vincentballendat/brakechopperRoot/Entwicklungsdokument/Brake_chopper_InOut.pptx

Temp (PCB, mounting base, casing)
Total Current
Battery Voltage

CAN TX/RX

System

1 x Powerstage vCtrl
5 x Powerstage Enable
3 x LEDs
1 x Fan Enable

## Slide 2

State Machine Diagram

Startup

Calibration
(if Vbat connected) (Powerstage, ADC)

Ready (VCtrl = 0, SHDN = 0)

CAN: take load

CAN: no load

Overtemp (VCtrl = 0, SHDN = 0)

CAN: take load

Burn Energy (VCtrl != 0, SHDN != 0)

CAN: no load

Powerstages set and measured

Burn Energy
SOA Throttling (VCtrl != 0, SHDN != 0)

## Slide 3

Ready State Housekeeping

Power-Handler
setSOACurrent();
setVCtrl();

Timer
ADC Filtering, powerHandler,
calculateExcessCurrent,
setCurrent

CAN Interrupt
New excess current

Calculate excess current
= -motorLinkCurrent
-generatorPower/Voltage
-Battery chargeCurrent 2S

Calculate dissipationCurrent
Adjusts excess current current if higher than:
SOAPower
MaxTempdependentPower
Ptot Mosfet

dissipationCurrent

setCurrent

setSOACurrent();

100Hz

setVCtrl();

setVCtrl()
Adjusts the DAC to output the voltage representing the dissipationCurrent

setCurrent
dissipationCurrent
Activates Powerstages depending on current and calibration

setCurrent();
