vincentballendat/brakechopperRoot/Can Motor controller CAN Messages.PNG

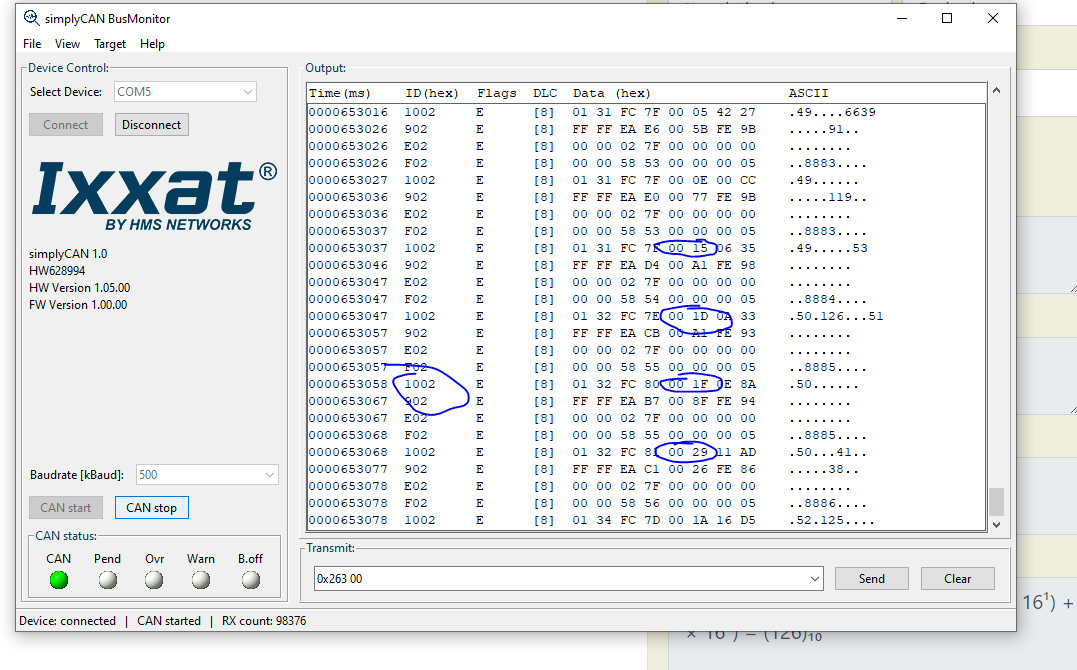
Can Motor controller CAN Messages.PNG
