vincentballendat/brakechopperRoot/Entwicklungsdokument/Example Layout DCDC.PNG

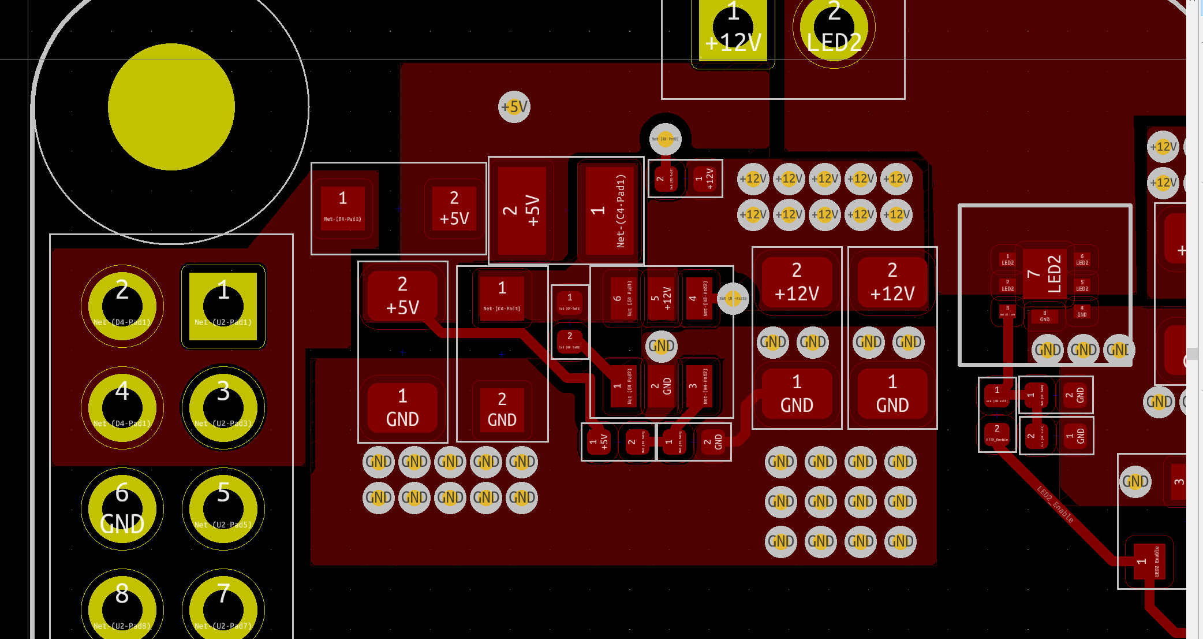
Entwicklungsdokument/Example Layout DCDC.PNG
