vincentballendat/brakechopperRoot/KiCad/Brake_Chopper/Brake_Chopper_BOM.xlsx

Id | Designator | Package | Quantity | Designation | Supplier and ref | Preis/ Stk (ab 10 stk) | Gesamtpreis / PCB
1 | L2,L1 | L_1008_2520Metric | 2 | 4,7uH |  | 1.77 € | 3.54 € | https://www.mouser.de/ProductDetail/NXP-Semiconductors/TJA1050T-CM118?qs=5XOdhvmYM0NFFspw0VP5sA%3D%3D
2 | C9,C8,C2,C3 | C_0805_2012Metric | 4 | 10uF |  |  | 0.00 €
3 | D4,D10,D3,D5,D7,D6,D8,D9 | LED_0603_1608Metric | 8 | LED |  |  | 0.00 €
4 | R49,R55,R53,R46,R6,R44,R57,R56,R40,R14,R52,R54,R59,R51,R5,R10,R58,R13,R42,R1,R50,R8,R25 | R_0402_1005Metric | 23 | 10k |  |  | 0.00 €
5 | R15,R16,R43,R17,R39,R3,R23,R27,R31,R35 | R_0402_1005Metric | 10 | 1k |  |  | 0.00 €
6 | C15,C14,C16,C17,C18 | C_2220_5650Metric | 5 | 10u 100V! |  | 1.31 € | 6.55 € | https://www.mouser.de/ProductDetail/KYOCERA-AVX/22201C106MAT2A?qs=LGawwvMOr29m3pBB9JVCfA%3D%3D
7 | R12,R38 | R_0402_1005Metric | 2 | 4,7k |  |  | 0.00 €
8 | C38,C13,C27,C29,C21,C12,C35,C33,C39,C26,C22,C28,C1,C41,C20,C32,C40,C19,C37,C25,C30,C36,C11,C34,C23,C10 | C_0402_1005Metric | 26 | 100n |  |  | 0.00 €
9 | D12,D11,D13 | LED_D5.0mm | 3 | LED |  |  | 0.00 €
10 | R4,R24,R32,R28,R36 | R_2512_6332Metric | 5 | 30m | D1MPAC2512QR030FA-T4 | 0.14 € | 0.70 € | https://www.digikey.com.br/en/products/detail/thin-film-technology-corp/D1MPAC2512QR030FA-T4/16735398
11 | R45 | R_0402_1005Metric | 1 | 120 |  | 0.01 € | 0.01 € | https://www.mouser.de/ProductDetail/KOA-Speer/RK73H1ETTP1200F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
12 | D2,D1 | D_SOD-123F | 2 | DS14W |  |  | 0.00 €
13 | U7,U6 | PE24_SMD_IBT | 2 | SMT NAT M4 (Redcube) |  | 0.26 € | 0.52 €
14 | U11,U10,U9,U8,U1 | SOT-23-6 | 5 | TLV9101SIDBVR |  | 0.74 € | 3.70 €
15 | TH1 | R_0402_1005Metric | 1 | Thermistor_NTC | NCU15XH103E6SRC | 0.09 € | 0.09 € | https://www.mouser.de/ProductDetail/Murata-Electronics/NCU15XH103E6SRC?qs=qSfuJ%252Bfl%2Fd6uneJyel0xyQ%3D%3D
16 | U2 | LQFP-48_7x7mm_P0.5mm | 1 | STM32F072C8Tx |  | 4.52 € | 4.52 €
18 | FID3,FID2,FID1,FID4 | Fiducial_0.5mm_Mask1mm | 4 | Fiducial |  |  | 0.00 €
19 | J3 | PinHeader_1x05_P2.54mm_Vertical | 1 | Conn_01x05_Male |  |  | 0.00 €
20 | R60,R11,R9,R7,R48,R18,R33,R37 | R_0402_1005Metric | 8 | 100k |  |  | 0.00 €
21 | R2,R30,R29,R34,R22,R26 | R_0402_1005Metric | 6 | 100R |  | 0.02 € | 0.11 € | https://www.mouser.de/ProductDetail/Vishay-Dale/CRCW0402100RFKED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
22 | FB2,FB3,FB1 | D_0603_1608Metric | 3 | FerriteBead |  | 0.17 € | 0.50 € | https://www.mouser.de/ProductDetail/Wurth-Elektronik/74279265?qs=5twSNpOB8IBYQvSbutOy0w%3D%3D
23 | R41 | R_0402_1005Metric | 1 | 65k |  | 0.01 € | 0.01 € | https://www.mouser.de/ProductDetail/YAGEO/AC0402FR-0764K9L
24 | C4,C5 | C_0805_2012Metric | 2 | 68pF |  | 0.03 € | 0.06 € | https://www.mouser.de/ProductDetail/Walsin/0805N680J201CT
25 | C31 | C_0805_2012Metric | 1 | 1u |  |  | 0.00 €
26 | U13 | SOT-23 | 1 | PESD2CAN |  | 0.42 € | 0.42 € | https://www.mouser.de/ProductDetail/Nexperia/PESD2CAN215?qs=LOCUfHb8d9sqg7TaLUP2JQ%3D%3D
27 | R21 | R_2512_6332Metric | 1 | 0R01 | CRF2512-JZ-R010ELF | 0.35 € | 0.35 € | https://www.mouser.de/ProductDetail/Bourns/CRF2512-JZ-R010ELF?qs=Xowbq3obBahhwSE1OziLPA%3D%3D
28 | C6,C7 | C_0805_2012Metric | 2 | 220n |  | 0.02 € | 0.04 € | https://www.mouser.de/ProductDetail/Samsung-Electro-Mechanics/CL21B224KBFNNNG
30 | Q2 | PowerPAK_SO-8_Single | 1 | SIRA18ADP-T1-GE3 |  | 0.37 € | 0.37 € | https://www.mouser.de/ProductDetail/Vishay-Semiconductors/SIRA18ADP-T1-GE3?qs=ojKcPFmCWSVrk7Ja81e2IA%3D%3D
31 | U3 | SOIC-8_3.9x4.9mm_P1.27mm | 1 | TJA1051T | TJA1050T/CM,118 | 1.77 € | 1.77 € | https://www.mouser.de/ProductDetail/NXP-Semiconductors/TJA1050T-CM118?qs=5XOdhvmYM0NFFspw0VP5sA%3D%3D
32 | U4,U5 | SOT-23-6 | 2 | ME3116 |  | 0.21 € | 0.42 €
33 | J1 | JST_XH_B04B-XH-A_04x2.50mm_Straight | 1 | Conn_01x04_Male |  |  | 0.00 €
34 | J2,J5,J4 | JST_XH_B02B-XH-A_02x2.50mm_Straight | 3 | Conn_01x02_Male |  |  | 0.00 €
35 | R20,R19 | R_0402_1005Metric | 2 | 470k |  | 0.01 € | 0.02 € | https://www.mouser.de/ProductDetail/YAGEO/RC0402FR-13470KL?qs=sGAEpiMZZMvdGkrng054t5h1zTYPh4vhbyn0hIjpgP8%3D
36 | U12 | SOT-23-6 | 1 | INA181 | INA181A1QDBVRQ1 | 0.58 € | 0.58 € | https://www.mouser.de/ProductDetail/Texas-Instruments/INA181A1QDBVRQ1?qs=EBDBlbfErPx7yYU5sEtaJQ%3D%3D
38 | Q1,Q3,Q6,Q5,Q4 | TO-220-3_Horizontal_TabUp | 5 | PSMN057-200P |  | 1.22 € | 6.10 €
 |  |  | 1 | Gehäuse | L02A | 15.16 € | 15.16 €
 |  |  | 1 | Kabel |  | 2.00 € | 2.00 €
 |  |  |  |  |  | Gesamt: | 47.55 €
