vincentballendat/brakechopperRoot/Bauteile/Bestellliste_Digikey.xlsx

Index | Menge | Teilenummer | Hersteller-Teilenummer | Beschreibung | Kundenreferenz | Verfügbar | Lieferrückstände | Stückpreis | Gesamtpreis USD
1 | 238 | 2156-PSMN057-200P,127-1727-ND | PSMN057-200P,127 | NEXPERIA PSMN057-200P - 39A, 200 |  | 238 | 0 | 126000 | 29988
2 | 2 | 497-15096-ND | NUCLEO-F072RB | NUCLEO-64 STM32F072RB EVAL BRD |  | 2 | 0 | 1099000 | 2198
3 | 25 | 296-TLV9101SIDBVRCT-ND | TLV9101SIDBVR | IC OPAMP GP 1 CIRCUIT SOT23-6 |  | 25 | 0 | 77240 | 1931
4 | 10 | 497-17358-ND | STM32F072C8T6 | IC MCU 32BIT 64KB FLASH 48LQFP |  | 10 | 0 | 468600 | 4686
5 | 100 | 4463-D1MPAC2512QR030FA-T4CT-ND | D1MPAC2512QR030FA-T4 | RES 2512 50PPM 0.03 OHM 1.0% 3.0 |  | 100 | 0 | 14960 | 1496
6 | 1 | 1738-1374-ND | FIT0010 | JUMPER WIRE M TO M VARIOUS |  | 1 | 0 | 470000 | 470
7 | 1 | 1568-1511-ND | PRT-12794 | JUMPER WIRE M/F 6" 20PCS |  | 1 | 0 | 210000 | 210
8 | 1 | BKEXP-355-ND | EXP-355 | BREADBRD TERM STRIP 4.12X2.31" |  | 1 | 0 | 755000 | 755
9 | 1 | PA0085-ND | PA0085 | SOT23-6/SC59-6 TO DIP-6 SMT ADAP |  | 1 | 0 | 269000 | 269
