vincentballendat/brakechopperRoot/Bauteile/Nachbestellung Bauteile.xlsx

Bauteil | Bezeichnung | Preis/ Stk (ab 10 stk) | Anzahl | Gesamtpreis | Link
CAN Transceiver NUR MIT REFERENCE VOLTAGE PIN VERFÜGBAR | TJA1050T/CM,118 | 1.77 € | 10 | 17.70 € | https://www.mouser.de/ProductDetail/NXP-Semiconductors/TJA1050T-CM118?qs=5XOdhvmYM0NFFspw0VP5sA%3D%3D
MOSFET für Lüfter | SIRA18ADP-T1-GE3 | 0.37 € | 10 | 3.73 € | https://www.mouser.de/ProductDetail/Vishay-Semiconductors/SIRA18ADP-T1-GE3?qs=ojKcPFmCWSVrk7Ja81e2IA%3D%3D
Shunt für Gesamtstrom | CRF2512-JZ-R010ELF | 0.35 € | 10 | 3.55 € | https://www.mouser.de/ProductDetail/Bourns/CRF2512-JZ-R010ELF?qs=Xowbq3obBahhwSE1OziLPA%3D%3D
PESD2CAN | PESD2CAN,215 | 0.42 € | 10 | 4.16 € | https://www.mouser.de/ProductDetail/Nexperia/PESD2CAN215?qs=LOCUfHb8d9sqg7TaLUP2JQ%3D%3D
INA181 | INA181A1QDBVRQ1 | 0.58 € | 10 | 5.81 € | https://www.mouser.de/ProductDetail/Texas-Instruments/INA181A1QDBVRQ1?qs=EBDBlbfErPx7yYU5sEtaJQ%3D%3D
100R Resistor_SMD:R_0402_1005Metric Widerstand | CRCW0402100RFKED | 0.02 € | 200 | 3.60 € | https://www.mouser.de/ProductDetail/Vishay-Dale/CRCW0402100RFKED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
Ferrite Perle | 74279265 | 0.17 € | 30 | 4.98 € | https://www.mouser.de/ProductDetail/Wurth-Elektronik/74279265?qs=5twSNpOB8IBYQvSbutOy0w%3D%3D
65k Resistor_SMD:R_0402_1005Metric widerstand für Spannungsteiler INA181 Ref voltage | AC0402FR-0764K9L | 0.01 € | 200 | 2.00 € | https://www.mouser.de/ProductDetail/YAGEO/AC0402FR-0764K9L
220nF= 0,22uF 0805_2012Metric Kondensator DC DC Converter | CL21B224KBFNNNG | 0.02 € | 200 | 4.40 € | https://www.mouser.de/ProductDetail/Samsung-Electro-Mechanics/CL21B224KBFNNNG
68pF 0805_2012Metric Kondensator DC DC Converter | 0805N680J201CT | 0.03 € | 100 | 3.20 € | https://www.mouser.de/ProductDetail/Walsin/0805N680J201CT
10uF_2220_5650Metric 100V Kondensator | 22201C106MAT2A | 1.39 € | 25 | 34.75 € | https://www.mouser.de/ProductDetail/KYOCERA-AVX/22201C106MAT2A?qs=LGawwvMOr29m3pBB9JVCfA%3D%3D
ROT LED_THT:LED_D5.0mm | C5SMF-RJF-CT0W0BB1 | 0.13 € | 10 | 1.31 € | https://www.mouser.de/ProductDetail/Cree-LED/C5SMF-RJF-CT0W0BB1?qs=1sbE9T7hb3YqwRmUPU3V0Q%3D%3D
Grün LED_THT:LED_D5.0mm | C5SMF-GJF-CV0Y0791 | 0.18 € | 10 | 1.81 € | https://www.mouser.de/ProductDetail/Cree-LED/C5SMF-GJF-CV0Y0791?qs=1sbE9T7hb3bLY9RhY5fsuw%3D%3D
Blau LED_THT:LED_D5.0mm | C5SMF-BJE-CR0U0451 | 0.18 € | 10 | 1.81 € | https://www.mouser.de/ProductDetail/Cree-LED/C5SMF-BJE-CR0U0451?qs=1sbE9T7hb3bBR3Yepx7pEw%3D%3D
470k Resistor_SMD:R_0402_1005Metric | RC0402FR-13470KL | 0.01 € | 200 | 2.00 € | https://www.mouser.de/ProductDetail/YAGEO/RC0402FR-13470KL?qs=sGAEpiMZZMvdGkrng054t5h1zTYPh4vhbyn0hIjpgP8%3D
120R Resistor_SMD:R_0402_1005Metric für CAN | RK73H1ETTP1200F | 0.01 € | 200 | 2.60 € | https://www.mouser.de/ProductDetail/KOA-Speer/RK73H1ETTP1200F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
Termistor NTC Resistor_SMD:R_0402_1005Metric | NCU15XH103E6SRC | 0.09 € | 30 | 2.76 € | https://www.mouser.de/ProductDetail/Murata-Electronics/NCU15XH103E6SRC?qs=qSfuJ%252Bfl%2Fd6uneJyel0xyQ%3D%3D
 |  |  |  | 100.17 €
