vincentballendat/brakechopperRoot/Bauteile/MOSFET/MOSFET_Vergleich.xlsx

MOSFET | VDS | PD | Rth(j-mb) Typ (K/W) | Kosten | Kosten / 100 Watt
IPB020N10N5LF | 100 | 313 | 0.25 | 3.51 € | 1.12 €
IRFP150N | 100 | 160 | 1.1 | 0.80 € | 0.50 €
IRFB4510PBF | 100 | 140 | 1.05 | 1.68 € | 1.20 €
IRF3710PBF | 100 | 200 | 0.75 | 0.79 € | 0.40 €
PSMN3R7-100BSE | 100 | 405 | 0.3 | 4.47 € | 1.10 €
PSMN015-100P,127 | 100 | 300 | 0.5 | 2.48 € | 0.83 € | 2,31 € ab 10 Stück
PSMN057-200P | 200 | 250 | 0.6 | 1.55 € | 0.62 € | Beste Wahl? | Nur im Ausland bestellbar
IXTK90N25L2 | 250 | 960 | 0.13 | 37.36 € | 3.89 €
IXTP32N20T | 200 | 200 | 0.75 | 2.06 € | 1.03 €
IXTK200N10L2 | 100 | 1040 | 0.12 | 39.14 € | 3.76 €
IXTB30N100L | 1000 | 800 | 0.156 | 65.24 € | 8.15 €
IXFB300N10P | 100 | 1500 | 0.1 | 36.03 € | 2.40 €
IXFK230N20T | 200 | 1670 | 0.09 | 26.68 € | 1.60 € | SOA ohne DC aber vielversprechend
