vincentballendat/brakechopperRoot/Messungen + Tests/Strommessverstärker Stromkurve 1,5A -0,3A Step mit Abstecken.jpg

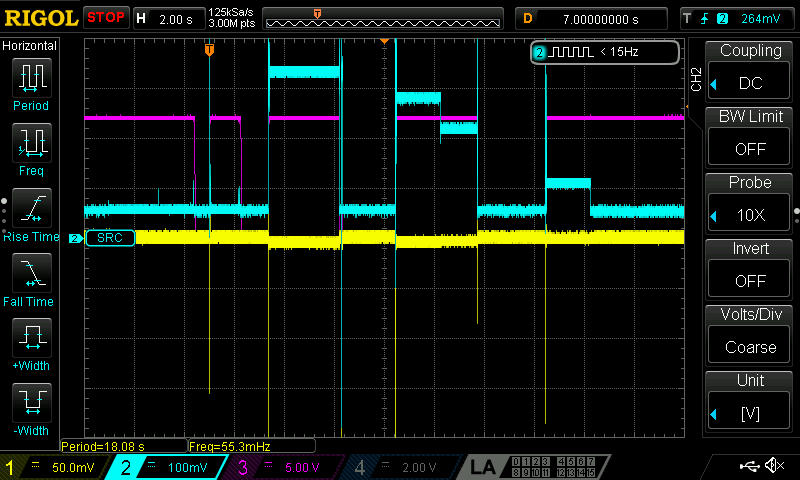
Messungen + Tests/Strommessverstärker Stromkurve 1,5A -0,3A Step mit Abstecken.jpg
