vincentballendat/brakechopperRoot/Messungen + Tests/Strommessverstärker Stromkurve 1,5A -0,3A Step.jpg

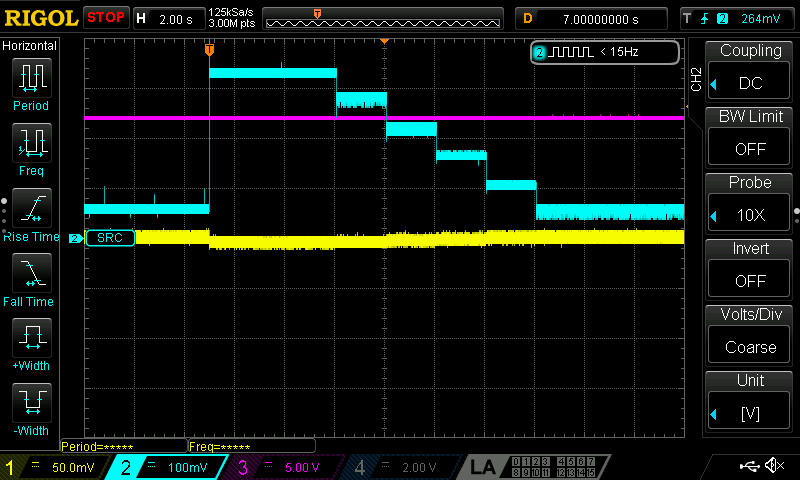
Messungen + Tests/Strommessverstärker Stromkurve 1,5A -0,3A Step.jpg
