vincentballendat/brakechopperRoot/Messungen + Tests/Messungen OpAmp Ausgang.xlsx

Object | Objective | Testing Procedure | Expected result
DC-DC Converter | Correct voltage for 3,3V | Connect +12V and GND to power supply with 0,5A current limit test the 3,3V testing point to GND | 3,3V +-0,2V measured, current stays <0,3A
DC-DC Converter | Correct voltage for 5V | Connect +12V and GND to power supply with 0,5A current limit test the 5V testing point to GND | 5V +-0,2V measured, current stays <0,3A
Results:
