vincentballendat/brakechopperRoot/Messungen + Tests/Messungen Stromfehler - Leg.xlsx

Vbat = 15V
Temp 23°C
Fehler = eingestellter Strom - gemessener Strom
 | Ampere/ Leg | Fehler Leg 1 | Fehler Leg 2 | Fehler Leg 3 | Fehler Leg 4 | Fehler Leg 5 | Gesamtstrom | Summe der Fehler | Prozent
 | 0.1 | 0.006 | -0.007 | 0.009 | 0.009 | 0.006 | 0.500 | 0.024 | 4.76% | -0.007 | -6.58%
 | 0.2 | 0.012 | -0.005 | 0.012 | 0.011 | 0.014 | 1.000 | 0.045 | 4.45% | -0.005 | -2.47%
 | 0.3 | 0.017 | -0.002 | 0.017 | 0.013 | 0.019 | 1.500 | 0.064 | 4.29% | -0.002 | -0.52%
 | 0.4 | 0.022 | 0.000352889299 | 0.020 | 0.014 | 0.026 | 2.000 | 0.082 | 4.09% | 0.000352889299 | 0.09%
 | 0.5 | 0.030 | 0.003 | 0.024 | 0.018 | 0.033 | 2.500 | 0.108 | 4.31% | 0.003 | 0.53%
 | 0.6 | 0.034 | 0.004 | 0.026 | 0.018 | 0.037 | 3.000 | 0.119 | 3.96% | 0.004 | 0.72%
 | 0.7 | 0.039 | 0.006 | 0.030 | 0.020 | 0.044 | 3.500 | 0.140 | 3.99% | 0.006 | 0.92%
 | 0.8 | 0.046 | 0.010 | 0.032 | 0.023 | 0.050 | 4.000 | 0.162 | 4.04% | 0.010 | 1.20%
 | 0.9 | 0.051 | 0.012 | 0.036 | 0.026 | 0.056 | 4.500 | 0.180 | 4.00% | 0.012 | 1.31%
 | 1.0 | 0.057 | 0.014 | 0.040 | 0.026 | 0.061 | 5.000 | 0.199 | 3.98% | 0.014 | 1.41%
 | 1.5 | 0.086 | 0.026 | 0.058 | 0.037 | 0.095 | 7.500 | 0.302 | 4.03% | 0.026 | 1.76%
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
