vincentballendat/brakechopperRoot/Messungen + Tests/Testing_Procedure.xlsx

Object | Objective | Testing Procedure | Expected result
DC-DC Converter | Correct voltage for 3,3V | Connect +12V and GND to power supply with 0,5A current limit test the 3,3V testing point to GND | 3,3V +-0,2V measured, current stays <0,3A
DC-DC Converter | Correct voltage for 5V | Connect +12V and GND to power supply with 0,5A current limit test the 5V testing point to GND | 5V +-0,2V measured, current stays <0,3A
Powerstages | No current upon connecting the battery | Connect BAT+ and BAT- to 12V power supply with 0,5A current limit | Power supply stays in constant voltage mode with a current <0,1A
Powerstages | No current upon connecting the battery | Connect +12V and GND, connect BAT+ and BAT- to 12V power supply with 0,5A current limit | Power supply stays in constant voltage mode with a current <0,1A
Powerstages | For each powerstage the set current gets consumed | Connect +12V and GND to power supply with 0,5A current limit. Connect BAT+ and BAT- to 12V power supply with 2A current limit. Start the testprogram, each Powerstage gets turned on and off individually one after another | Consumed current goes from 0A to 0,5A and back to 0A per powerstage. The LED of each powerstage lights up indicating activation
Powerstages | For each powerstage the set current gets consumed | Connect +12V and GND to power supply with 0,5A current limit. Connect BAT+ and BAT- to 12V power supply with 2A current limit. Start the testprogram, each Powerstage gets turned on and off individually one after another. Connect and disconnect the battery during this procedure | Consumed current goes from 0A to 0,5A +-0,05A and back to 0A per powerstage. The LED of each powerstage lights up indicating activation. The current doesn't show abnormal behaviour.
Voltage sensor | The correct voltage for battery gets measured | Connect +12V and GND to power supply with 0,5A current limit. Connect BAT+ and BAT- to 12V power supply with 2A current limit. Read out the measured voltage with CAN-Command | Measured voltage is 12V +-1V
Current Sensor | The amperage gets measured correctly | Connect +12V and GND to power supply with 0,5A current limit. Connect BAT+ and BAT- to 12V power supply with 2A current limit. Start the testprogram, Read out the measured amperage with CAN-Command | Measured amperage is 1,5A +-0,1A
Temperature Sensor | The temperature gets measured correctly | Let PCB sit for 10 minutes at room temperature, take note of room temperature. Connect +12V and GND to power supply with 0,5A current limit. Read out the measured temperature for temp1, temp2 and temp3 with CAN-Command | Measured temperature for each temperature sensor is room temperature +-5 degree
Fan connector | Fan is controlled correctly | Connect +12V and GND to power supply with 1A current limit. Control the fan with CAN-Command | Fan gets controlled correctly. Turns on and off with CAN-Command
