vincentballendat/brakechopperRoot/Messungen + Tests/01_Fahrversuch/Fahrversuch auswertung.xlsx

Sheet: Tabelle1
Time(ms) | ID(hex) | Flags | DLC | Data (HEX)
166078 | 0 |  | [5] | 0 | 0 | 0 | 0 | 96
166079 | 1AF0FE11 | E | [6] | 0 | 0 | 0 | 0 | 0 | 0
166088 | 1AF0FE11 | E | [6] | 0 | 0 | 0 | 0 | 0 | 0
166098 | 1AF0FE11 | E | [6] | 0 | 0 | 0 | 0 | 0 | 0
166101 | 400 |  | [5] | 0 | 0 | 0 | 0 | 23
166107 | 1AF0FE11 | E | [6] | 0 | 0 | 0 | 0 | 0 | 0
166117 | 1AF0FE11 | E | [6] | 0 | 0 | 0 | 0 | 0 | 0
166121 | 400 |  | [5] | 0 | 0 | 0 | 0 | 30
166127 | 1AF0FE11 | E | [6] | 0 | 0 | 0 | 0 | 0 | 0
166128 | 1AF0FC11 | E | [8] | 0 | 0 | 0 | 64 | 30 | 75
166137 | 1AF0FE11 | E | [6] | 0 | 0 | 0 | 0 | 0 | 0
166138 | 1AF0FB11 | E | [8] | 0 | 0 | 19 | F6 | 0 | 0
166141 | 400 |  | [5] | 0 | 0 | 0 | 0 | 37
166147 | 1AF0FE11 | E | [6] | 0 | 0 | 0 | 0 | 0 | 0
166148 | 1AF0F111 | E | [6] | 11 | 1 | 11 | 1 | 11 | 1
166157 | 1AF0FE11 | E | [6] | 0 | 0 | 0 | 0 | 0 | 0
166161 | 400 |  | [5] | 0 | 0 | 0 | 0 | 3D
166166 | 1AF0FE11 | E | [6] | 0 | 0 | 0 | 0 | 0 | 0
166176 | 1AF0FE11 | E | [6] | 0 | 0 | 0 | 0 | 0 | 0
166181 | 400 |  | [5] | 0 | 0 | 0 | 0 | 41
166186 | 1AF0FE11 | E | [6] | 0 | 0 | 0 | 0 | 0 | 0
166196 | 1AF0FE11 | E | [6] | 0 | 0 | 0 | 0 | 0 | 0
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
