vincentballendat/brakechopperRoot/Messungen + Tests/12V Batterie Voltage Sense Gelb.jpg

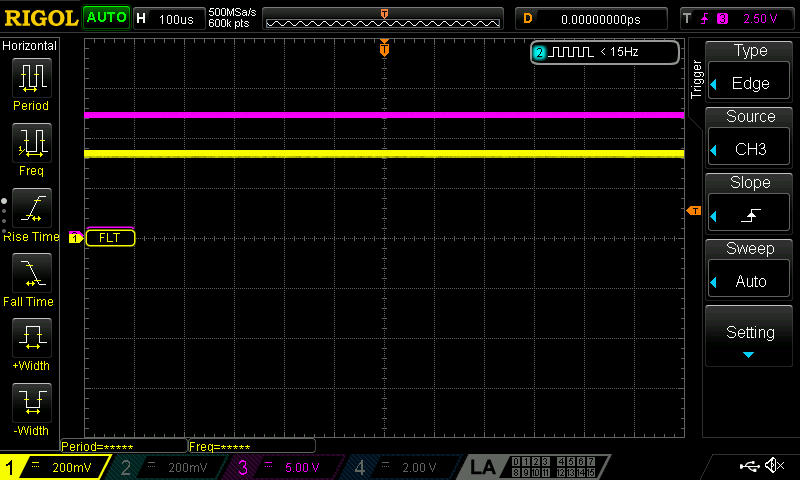
Messungen + Tests/12V Batterie Voltage Sense Gelb.jpg
