vincentballendat/brakechopperRoot/Messungen + Tests/Batterie Anschluss 100ms (Blau Stromverstärker).jpg

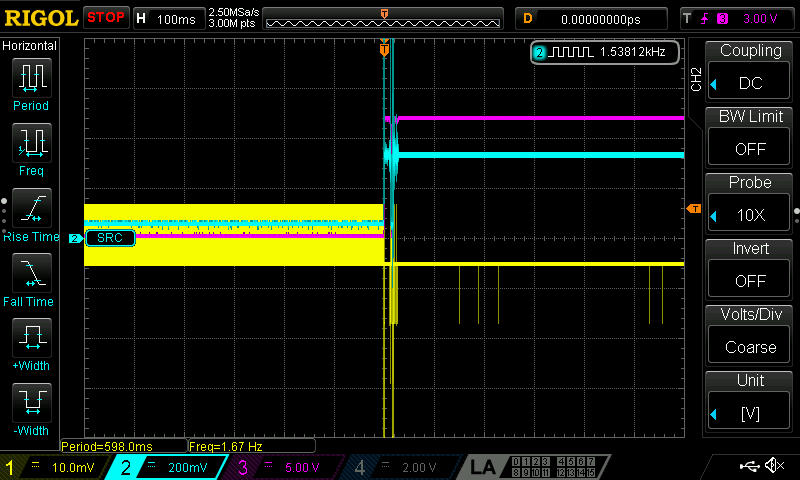
Messungen + Tests/Batterie Anschluss 100ms (Blau Stromverstärker).jpg
