vincentballendat/brakechopperRoot/Messungen + Tests/Batterie Anschluss  VoltageSense.jpg

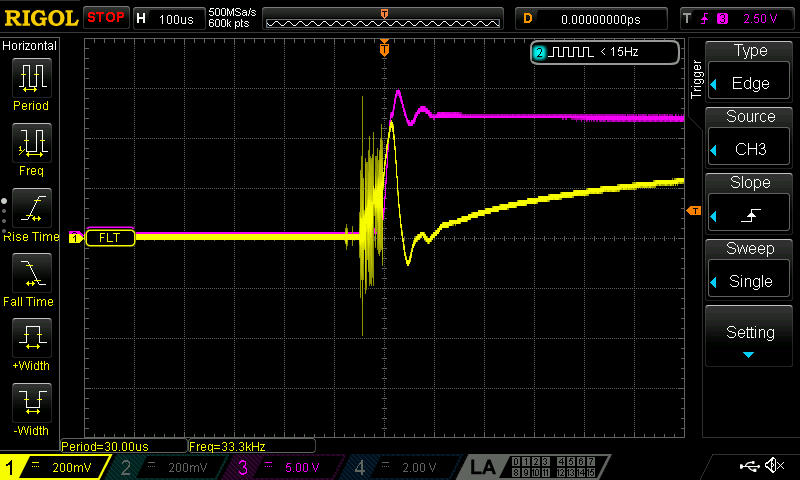
Messungen + Tests/Batterie Anschluss VoltageSense.jpg
