vincentballendat/brakechopperRoot/Messungen + Tests/OPAMP1 Ausgang.jpg

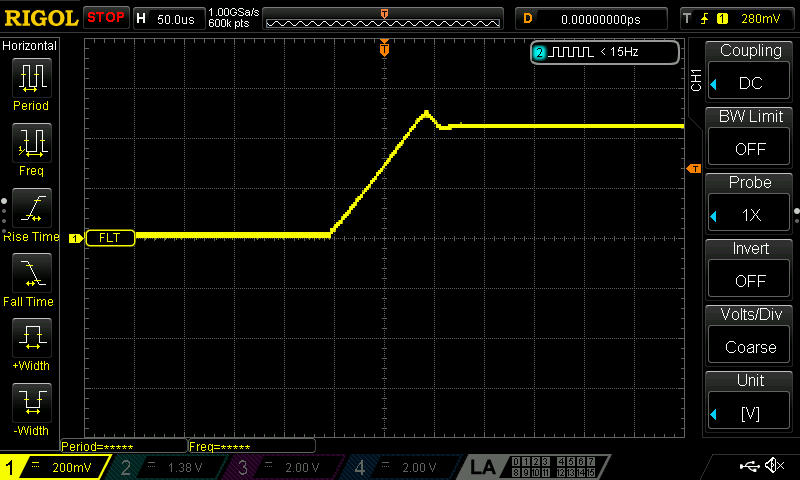
Messungen + Tests/OPAMP1 Ausgang.jpg
