vincentballendat/brakechopperRoot/Messungen + Tests/SHDN1.jpg

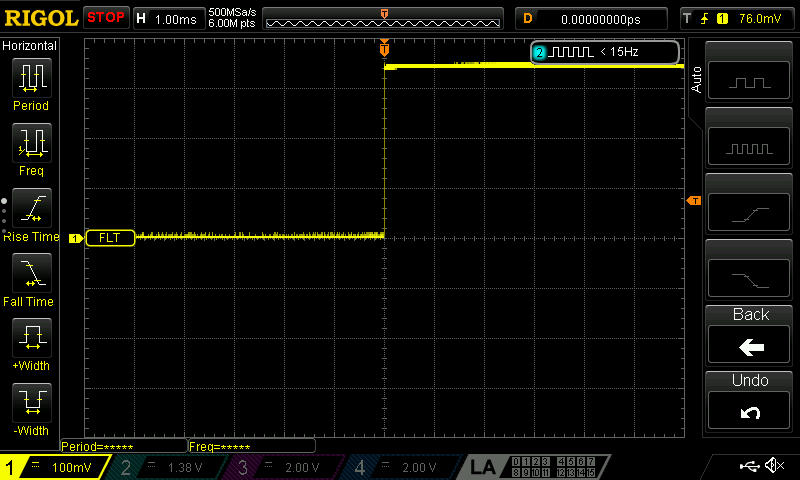
Messungen + Tests/SHDN1.jpg
