vincentballendat/brakechopperRoot/Messungen + Tests/Strommessung 1A (Blau Stromverstärker).jpg

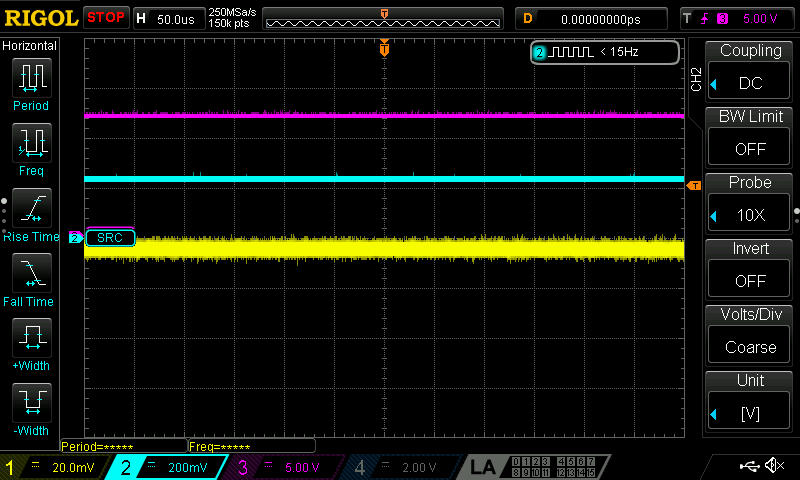
Messungen + Tests/Strommessung 1A (Blau Stromverstärker).jpg
