vincentballendat/brakechopperRoot/Messungen + Tests/Stromverstärker bei Spannungsänderung.jpg

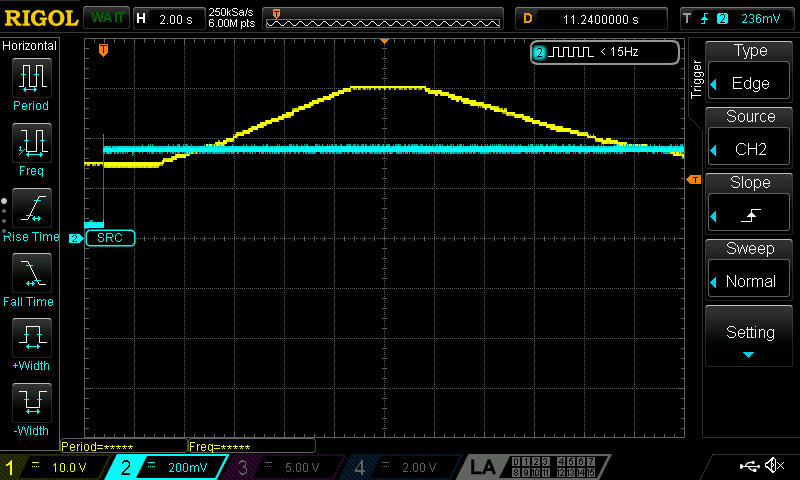
Messungen + Tests/Stromverstärker bei Spannungsänderung.jpg
