vincentballendat/brakechopperRoot/Messungen + Tests/Stromverstärker bei Stromänderung.jpg

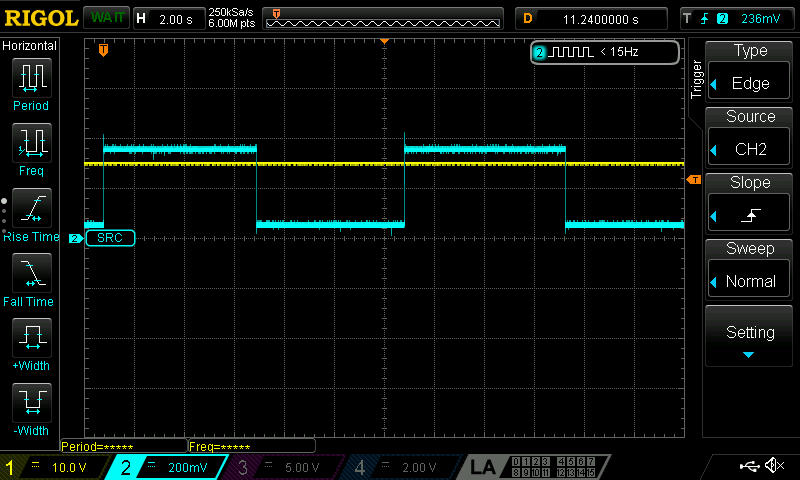
Messungen + Tests/Stromverstärker bei Stromänderung.jpg
