vincentballendat/brakechopperRoot/Messungen + Tests/Thermal throttling  60° Case (Blau Messverstärker) 2.jpg

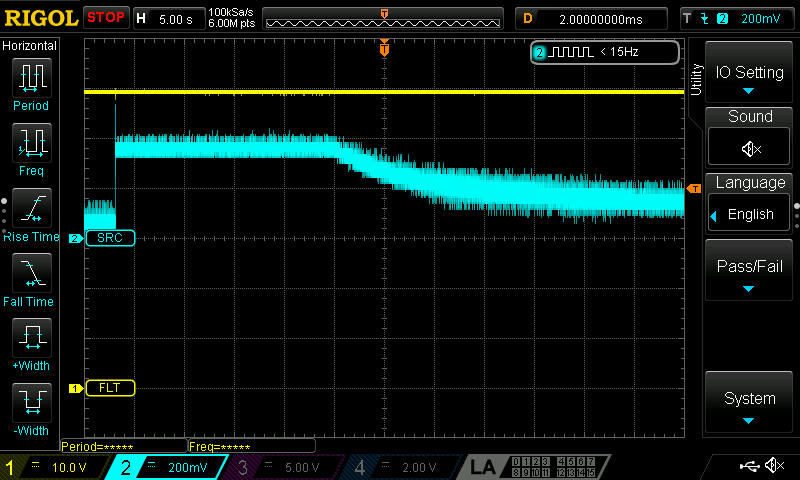
Messungen + Tests/Thermal throttling 60° Case (Blau Messverstärker) 2.jpg
