vincentballendat/brakechopperRoot/Gehäuse/YG-L02A-0053-000(合订全套-业务代码：FS-WME(L)110-65-25等级A).pdf

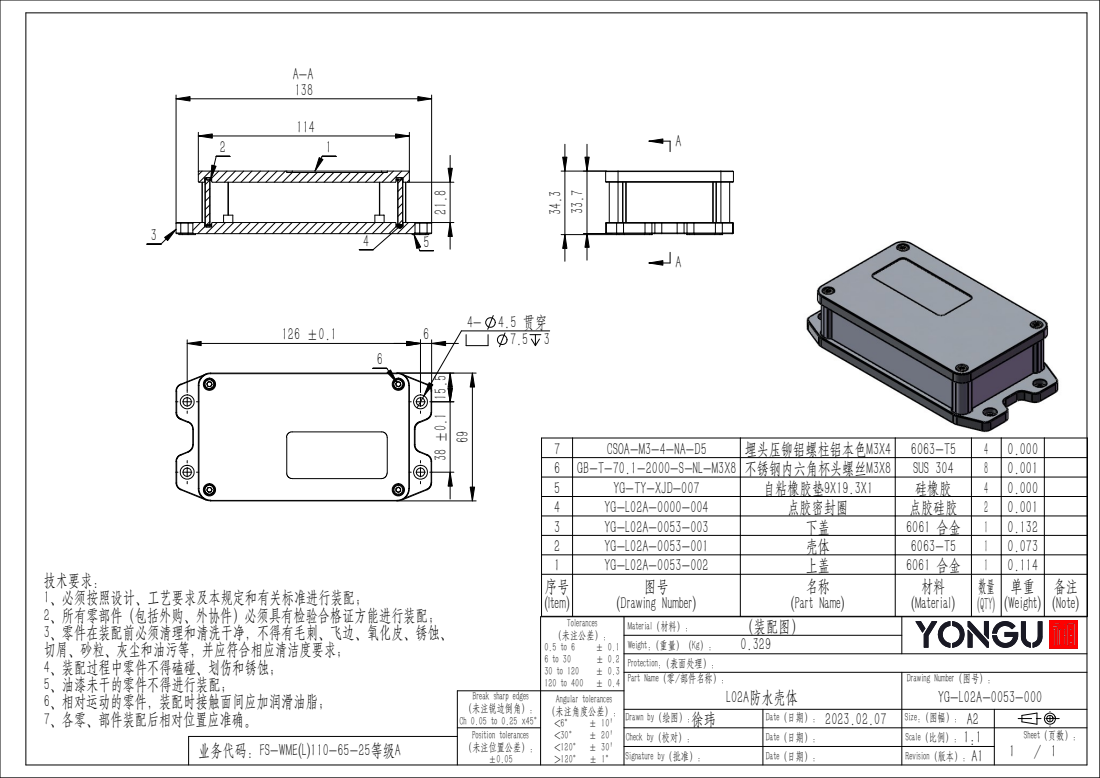
[picture p22: page 1]

7 | CSOA-M3-4-NA-D5 | 埋头压铆铝螺柱铝本色M3X4 | 6063-T5 | 4 | 0.000
6 | GB-T-70.1-2000-S-NL-M3X8 | 不锈钢内六角杯头螺丝M3X8 | SUS 304 | 8 | 0.001
5 | YG-TY-XJD-007 | 自粘橡胶垫9X19.3X1 | 硅橡胶 | 4 | 0.000
4 | YG-L02A-0000-004 | 点胶密封圈 | 点胶硅胶 | 2 | 0.001
3 | YG-L02A-0053-003 | 下盖 | 6061 合金 | 1 | 0.132
2 | YG-L02A-0053-001 | 壳体 | 6063-T5 | 1 | 0.073

技术要求：
1、必须按照设计、工艺要求及本规定和有关标准进行装配；
2、所有零部件（包括外购、外协件）必须具有检验合格证方能进行装配；
3、零件在装配前必须清理和清洗干净，不得有毛刺、飞边、氧化皮、锈蚀、
切屑、砂粒、灰尘和油污等，并应符合相应清洁度要求；
4、装配过程中零件不得磕碰、划伤和锈蚀；
5、油漆未干的零件不得进行装配；
6、相对运动的零件，装配时接触面间应加润滑油脂；
7、各零、部件装配后相对位置应准确。

序号 (Item) | 图号 (Drawing Number) | 名称 (Part Name) | 材料 (Material) | 数量 (QTY) | 单重 (Weight) | 备注 (Note)

Tolerances （未注公差）： 0.5 to 6 ± 0.1 6 to 30 ± 0.2 30 to 120 ± 0.3 120 to 400 ± 0.4 | Material（材料）: （装配图）

Weight:（重量）（Kg）：
Protection:（表面处理）：

Part Name（零/部件名称）: L02A防水壳体 | Drawing Number（图号）: YG-L02A-0053-000

Break sharp edges （未注锐边倒角）： Ch 0.05 to 0.25 x45° | Angular tolerances <6° ± 10' <30° ± 20' <120° ± 30' >120° ± 1°
徐玮 Drawn by（绘图）: | 2023.02.07 （未注角度公差）： Date（日期）： | A2 Size:（图幅）：
Position tolerances （未注位置公差）： ±0.05 | | Check by（校对）: | 1:1 Scale（比例）： | Sheet（页数）： 1 1 /
Signature by（批准）: | Revision（版本）： A1

业务代码：FS-WME(L)110-65-25等级A

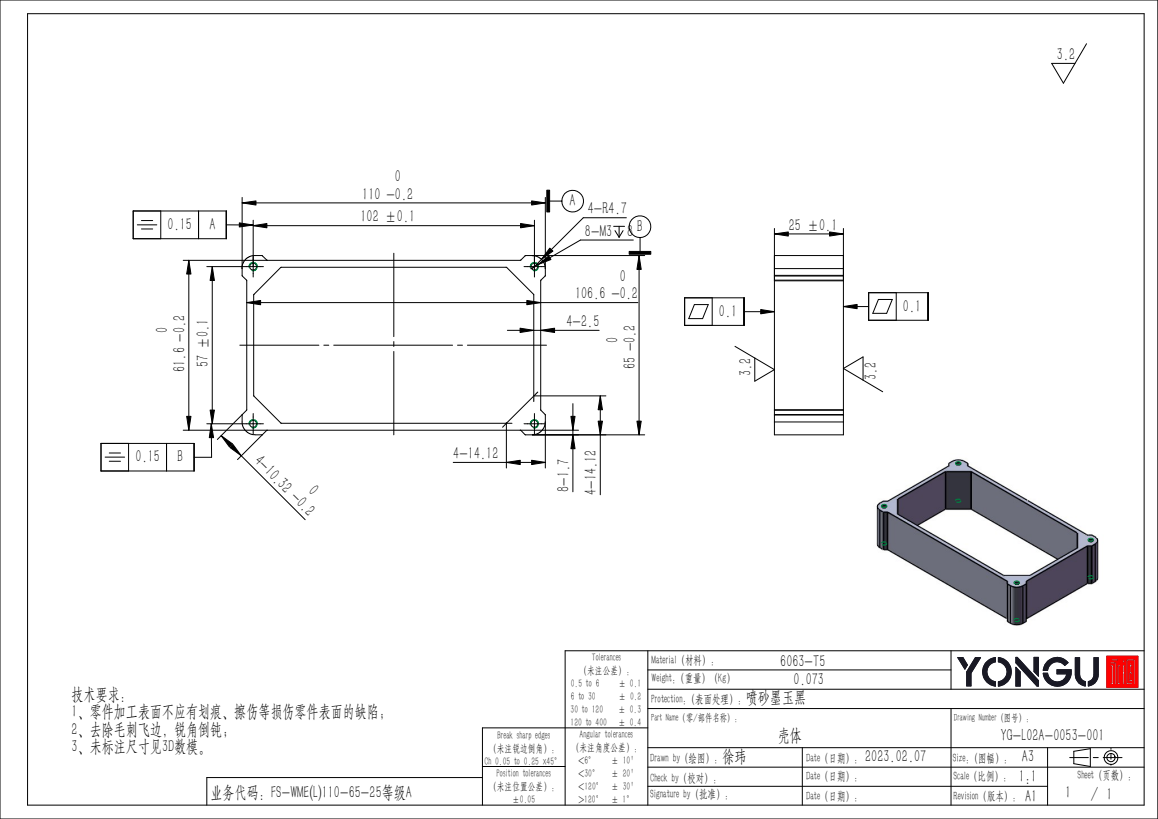
[picture p23: page 2]
喷砂墨玉黑; 技术要求： 1、零件加工表面不应有划痕、擦伤等损伤零件表面的缺陷； 2、去除毛刺飞边，锐角倒钝； 3、未标注尺寸见3D数模。

Material（材料）: Tolerances
（未注公差）：

Weight:（重量）（Kg）
Protection:（表面处理）：

Part Name（零/部件名称）: 壳体 | Drawing Number（图号）: YG-L02A-0053-001

Break sharp edges （未注锐边倒角）： | Angular tolerances （未注角度公差）： >120° ± 1°

（未注位置公差）： ±0.05 | | | 1 1

Signature by（批准）: | A1

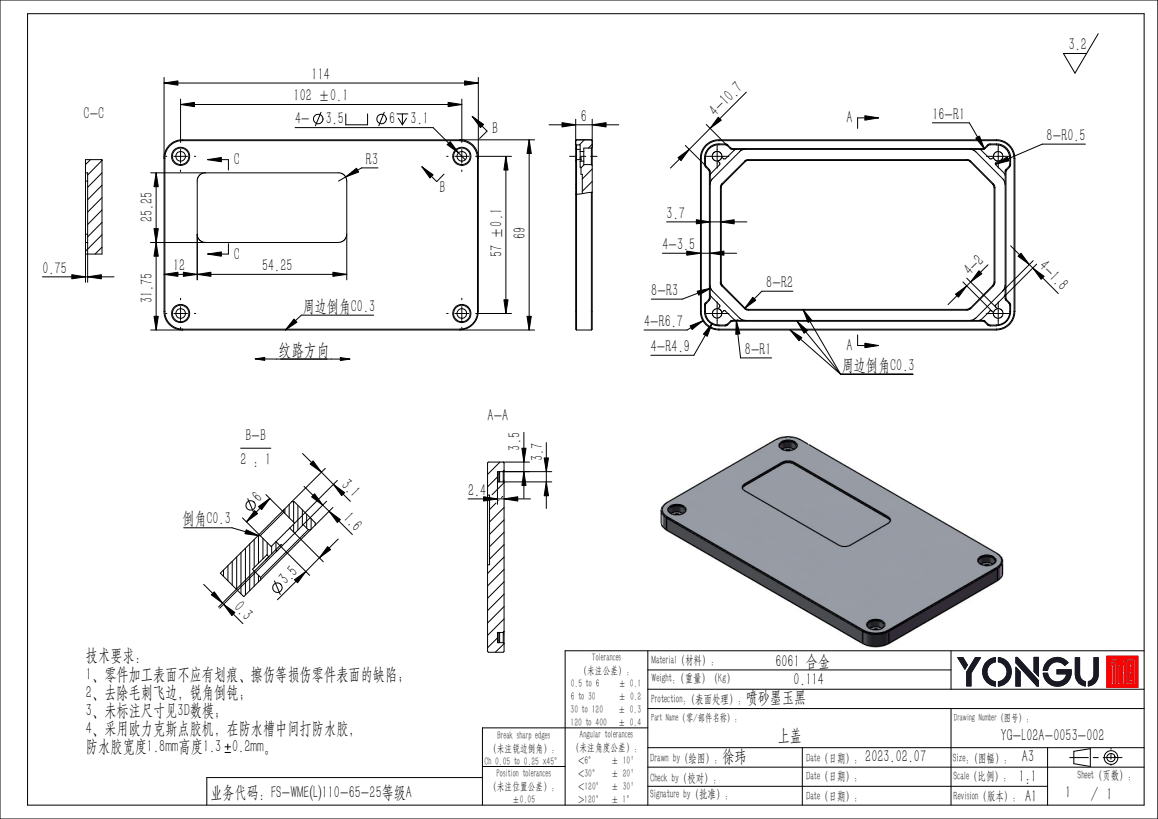
[picture p24: page 3]
纹路方向; 喷砂墨玉黑; 周边倒角C0.3 ²⁵.25; 倒角C0.3; 4、采用欧力克斯点胶机，在防水槽中间打防水胶，; 防水胶宽度1.8mm高度1.3; 技术要求： 1、零件加工表面不应有划痕、擦伤等损伤零件表面的缺陷； 2、去除毛刺飞边，锐角倒钝； 3、未标注尺寸见3D数模；; 周边倒角C0.3

Material（材料）: Tolerances
0.114 （未注公差）：

Weight:（重量）（Kg）
Protection:（表面处理）：

Part Name（零/部件名称）: 上盖 | Drawing Number（图号）: YG-L02A-0053-002

Break sharp edges （未注锐边倒角）： Ch 0.05 to 0.25 x45° | Angular tolerances （未注角度公差）： <120° ± 30' >120° ± 1°
徐玮 | 2023.02.07

Signature by（批准）: | | A1
1 / 1

20.83 16.21

## 8-R3¹⁵.5

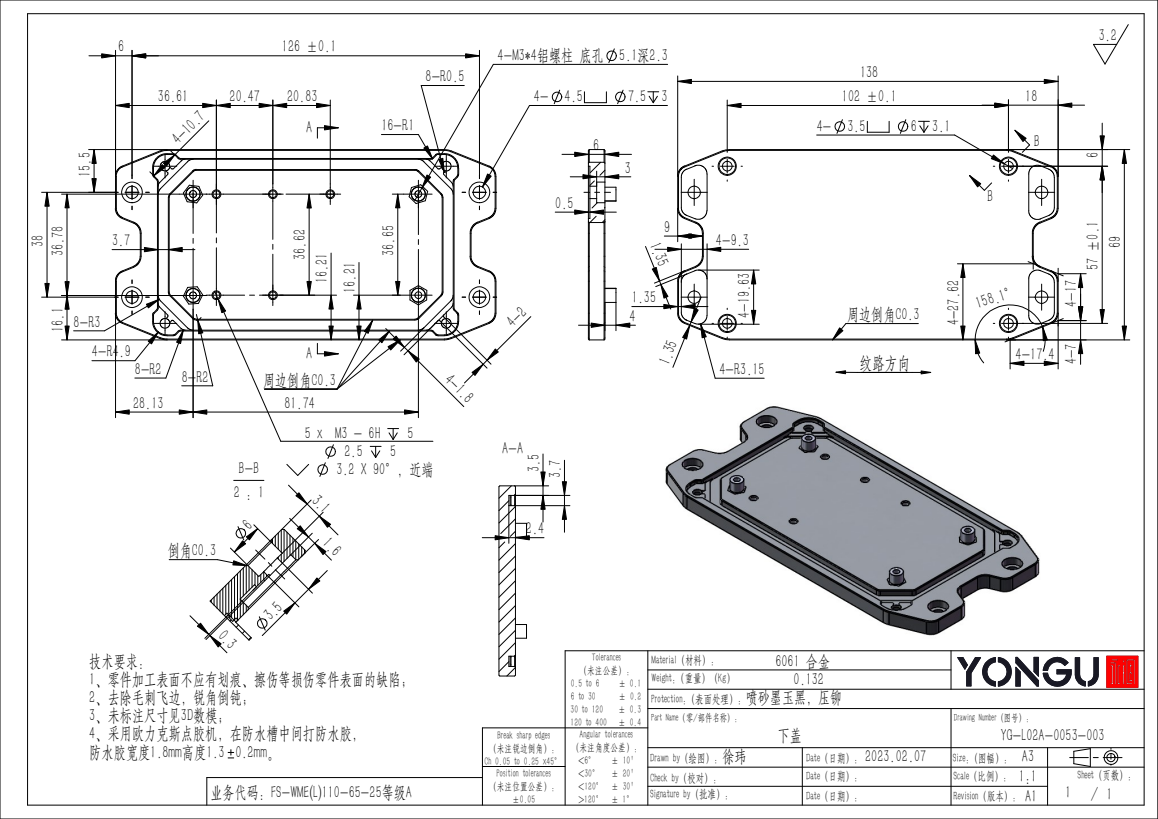
[picture p25: page 4]
纹路方向; 喷砂墨玉黑，压铆; Signature by（批准）:; 周边倒角C0.3; 防水胶宽度1.8mm高度1.3; 4、采用欧力克斯点胶机，在防水槽中间打防水胶， 0.2mm。; 技术要求： 1、零件加工表面不应有划痕、擦伤等损伤零件表面的缺陷； 2、去除毛刺飞边，锐角倒钝； 3、未标注尺寸见3D数模；; 4-M3*4铝螺柱 底孔 5.1深2.3; 倒角C0.3

Material（材料）: Tolerances
（未注公差）：
Angular tolerances
（未注角度公差）：

Weight:（重量）（Kg）
Protection:（表面处理）：

Part Name（零/部件名称）: 下盖 | Drawing Number（图号）: YG-L02A-0053-003

Break sharp edges
（未注锐边倒角）：

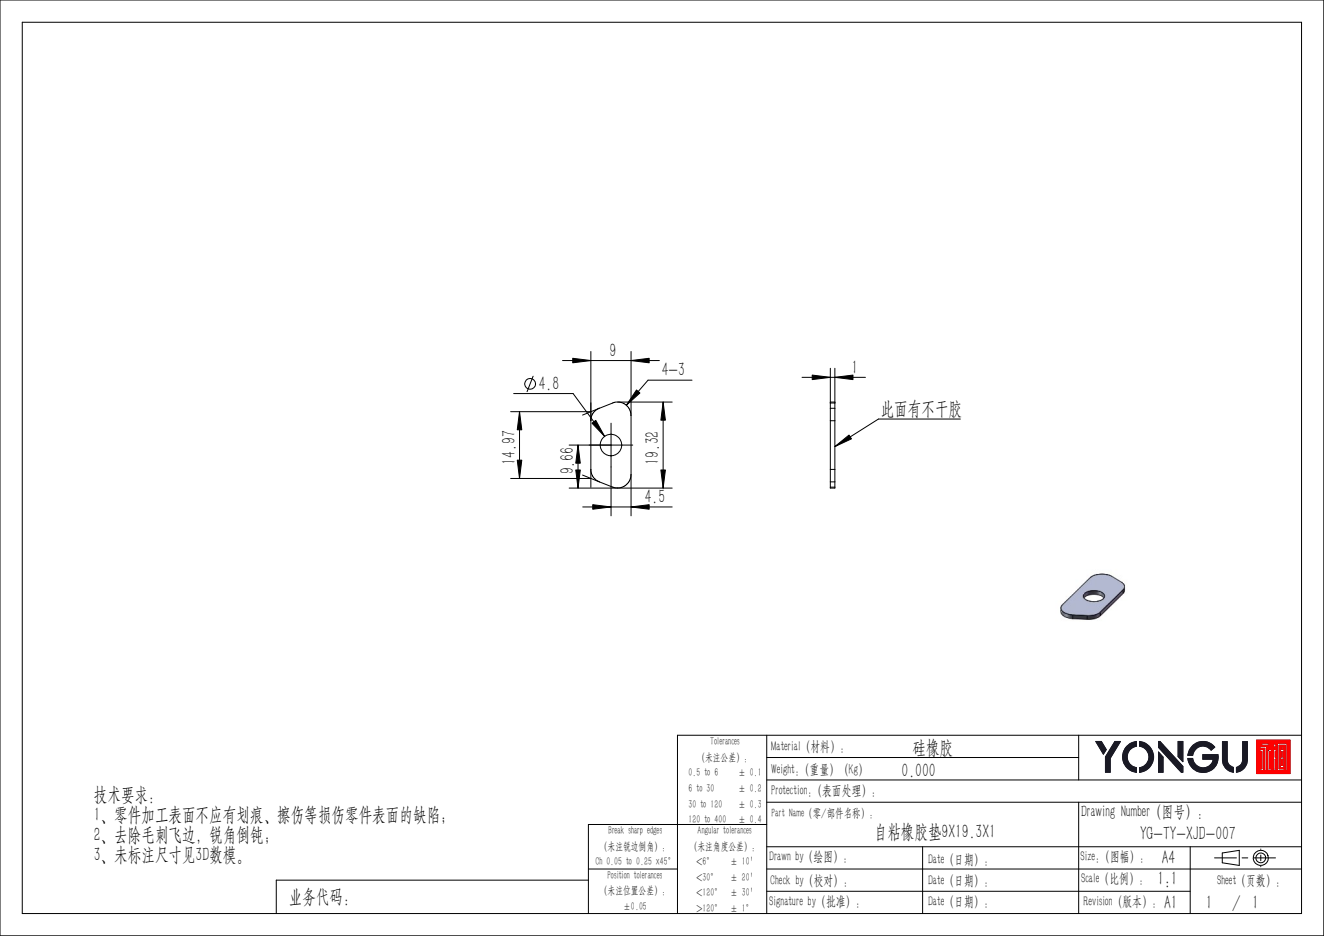
[picture p26: page 5]
硅橡胶; Tolerances （未注公差）：; 业务代码：; 技术要求： 1、零件加工表面不应有划痕、擦伤等损伤零件表面的缺陷； 2、去除毛刺飞边，锐角倒钝； 3、未标注尺寸见3D数模。; 此面有不干胶

Material（材料）:
Weight:（重量）（Kg）
Protection:（表面处理）：

Part Name（零/部件名称）: 自粘橡胶垫9X19.3X1 | Drawing Number（图号）: YG-TY-XJD-007

Break sharp edges （未注锐边倒角）： | Angular tolerances （未注角度公差）： >120° ± 1°

Drawn by（绘图）: | | Size:（图幅）： A4

Signature by（批准）:
