vincentballendat/brakechopperRoot/Gehäuse/YG-L02E-0005-002.pdf

6 3.2

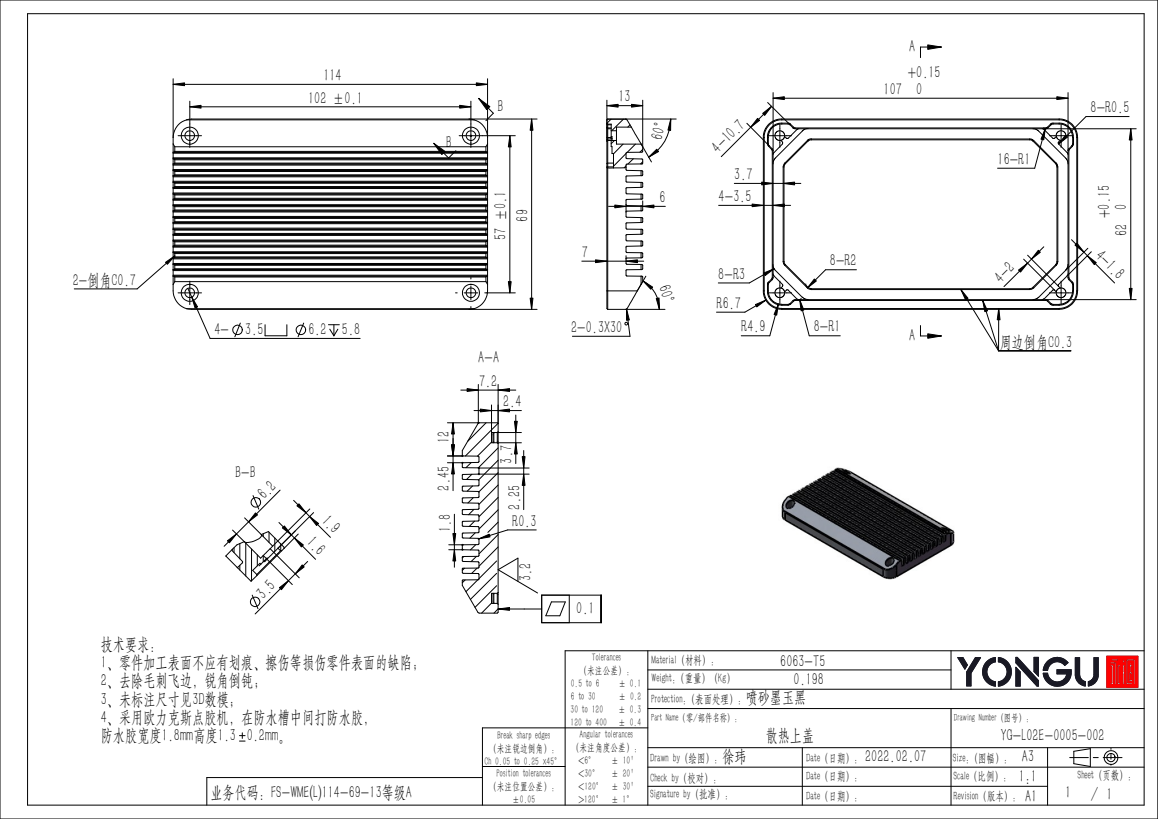
[picture p27: page 1]
喷砂墨玉黑; 周边倒角C0.3; 技术要求： 1、零件加工表面不应有划痕、擦伤等损伤零件表面的缺陷； 2、去除毛刺飞边，锐角倒钝； 3、未标注尺寸见3D数模； 4、采用欧力克斯点胶机，在防水槽中间打防水胶，; 防水胶宽度1.8mm高度1.3; 2-倒角C0.7

Material（材料）: Tolerances
（未注公差）：

Weight:（重量）（Kg）
Protection:（表面处理）：

Part Name（零/部件名称）: 散热上盖 | Drawing Number（图号）: YG-L02E-0005-002

Break sharp edges （未注锐边倒角）： Ch 0.05 to 0.25 x45° | Angular tolerances （未注角度公差）： <6° ± 10' <30° ± 20' <120° ± 30' >120° ± 1°

徐玮 Drawn by（绘图）: | 2022.02.07 Date（日期）： | A3 Size:（图幅）：

Position tolerances （未注位置公差）： ±0.05 | | Check by（校对）: | Date（日期）： | 1:1 Scale（比例）： | Sheet（页数）： 1 / 1

业务代码：FS-WME(L)114-69-13等级A

Signature by（批准）: | Date（日期）： | A1 Revision（版本）：
