vincentballendat/brakechopperRoot/CAN Filter Config.txt

1000000000000100
1010000001100100
1000000000000   = Filter
1010000001100   = Maske

11010111100001111100100010001 ==  Batterie
1000000000010 			== Motor strom
1101100000010			Motor Spannung






stdID:

100110001100000		== Filter
11100110000000000 =Maske

1001100011 		== Generator
10000000000
10000000001
10000000010
10000000011
10000000100
10000000101
10000000110
10000000111
10000001000
10000001001
